tstoegi/MicroWakeupper/pics/6.2/P1.JPG

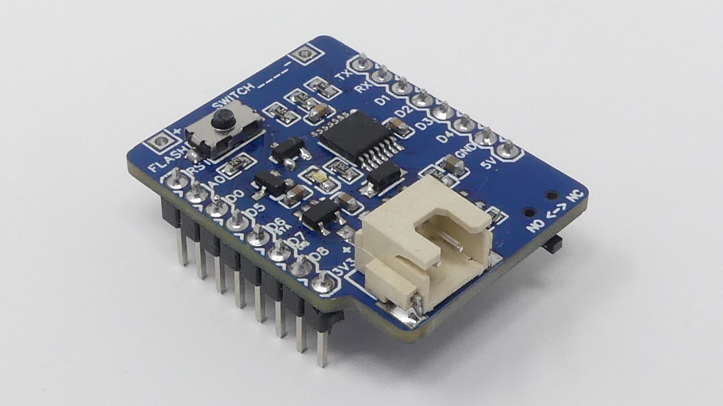
pics/6.2/P1.JPG
