tstoegi/MicroWakeupper/pics/6.2/P2.JPG

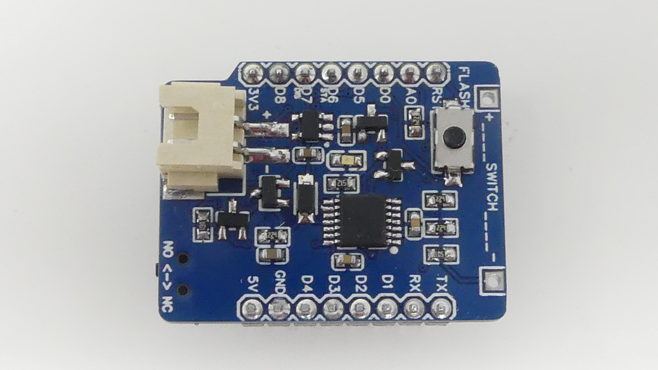
pics/6.2/P2.JPG
