tstoegi/MicroWakeupper/pics/6.2/P3.JPG

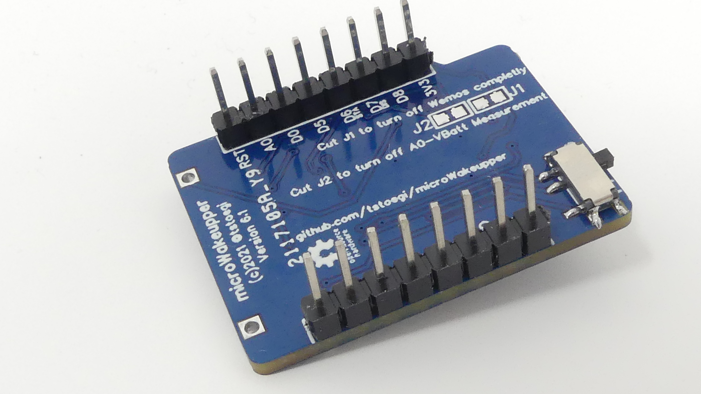
pics/6.2/P3.JPG
