tstoegi/MicroWakeupper/pics/6.2/P4.JPG

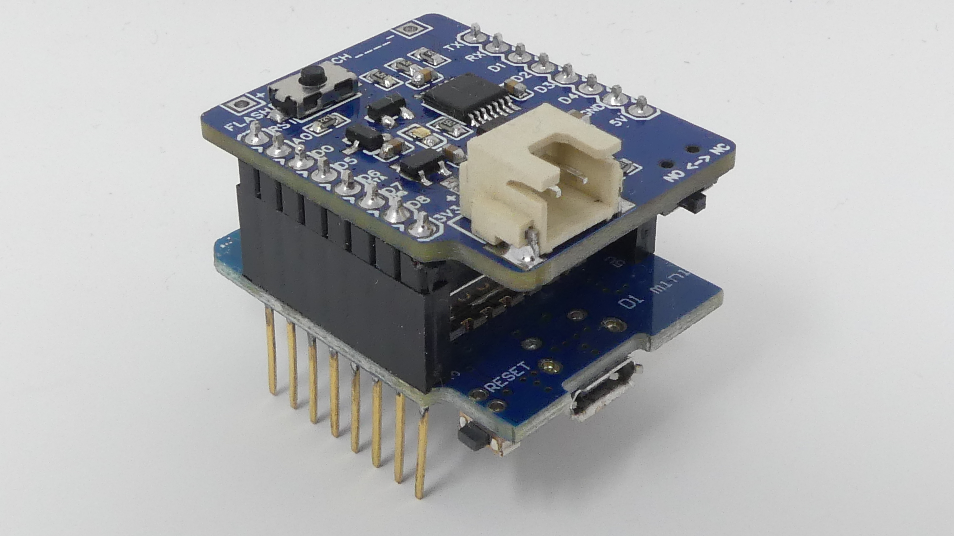
pics/6.2/P4.JPG
