tstoegi/MicroWakeupper/pics/6.3/P3.JPG

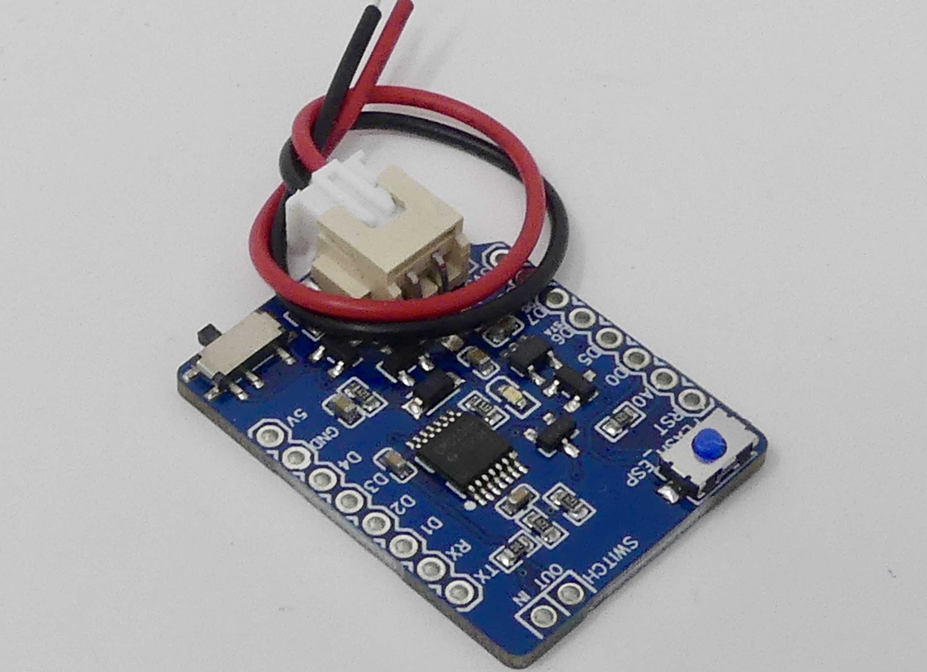
pics/6.3/P3.JPG
