tstoegi/MicroWakeupper/pcb/Gerber_R7_1/BOM_MicroWakeupper_R7_1_MicroWakeupper_WemosShield_R7_1_2025-09-15.xlsx

No. | Quantity | Comment | Designator | Footprint | Value | Manufacturer Part | Manufacturer | Supplier Part | Supplier
1 | 2 | 100nF | C1,C2 | C0603 |  | CC0603KRX7R9BB104 | YAGEO(国巨) | C14663 | LCSC
2 | 1 | 22uF | C4 | C0603 |  | CL10A226MQ8NRNC | SAMSUNG(三星) | C59461 | LCSC
3 | 2 | 1uF | C5,C6 | C0603 |  | CL10A105KB8NNNC | SAMSUNG(三星) | C15849 | LCSC
4 | 1 | WAFER-254W-2A | CN1 | CONN-SMD_2P-L10.0-W7.8-P2.5 |  | WAFER-254W-2A | HANBO(汉博) | C2874547 | LCSC
5 | 1 | B5819W_C8598 | D1 | SOD-123_L2.7-W1.6-LS3.7-RD-1 |  | B5819W SL | CJ(江苏长电/长晶) | C8598 | LCSC
6 | 2 | 0603 | J1,J2 | R0603 CUTTABLE JUMPER
7 | 1 | KT-0603R | LED1 | LED0603-RD |  | KT-0603R | KENTO | C2286 | LCSC
8 | 2 | 2N7002 | Q1,Q2 | SOT-23-3_L2.9-W1.3-P1.90-LS2.4-BR |  | 2N7002 | CJ(江苏长电/长晶) | C8545 | LCSC
9 | 1 | BC847B | Q3 | SOT-23-3_L2.9-W1.3-P1.90-LS2.4-BR |  | BC847B | UMW(友台半导体) | C545561 | LCSC
10 | 1 | SI2301CDS-T1-GE3 | Q4 | SOT-23-3_L3.0-W1.7-P0.95-LS2.9-BR |  | SI2301CDS-T1-GE3 | VISHAY(威世) | C10487 | LCSC
11 | 4 | 220K | R1,R2,R4,R8 | R0603 |  | 0603WAF2203T5E | UNI-ROYAL(厚声) | C22961 | LCSC
12 | 1 | 5.1K | R3 | R0603 |  | 0603WAF5101T5E | UNI-ROYAL(厚声) | C23186 | LCSC
13 | 1 | 1M | R5 | R0603 |  | 0603WAF1004T5E | UNI-ROYAL(厚声) | C22935 | LCSC
14 | 1 | 150 | R6 | R0603 |  | 0603WAF1500T5E | UNI-ROYAL(厚声) | C22808 | LCSC
15 | 1 | MSK12C02-HB | SW1 | SW-TH_MSK12C02-HB-1 |  | MSK12C02-HB | SHOU HAN(首韩) | C431541 | LCSC
16 | 1 | CD40106BPWR | U1 | TSSOP-14_L5.0-W4.4-P0.65-LS6.4-BL |  | CD40106BPWR | TI(德州仪器) | C58834 | LCSC
17 | 1 | AP2112K-3.3TRG1 | U2 | SOT-25-5_L3.0-W1.8-P0.95-LS3.0-BR |  | AP2112K-3.3TRG1 | DIODES(美台) | C51118 | LCSC
18 | 1 | KSR223GNCLFG | U3 | KEY-SMD_L6.0-W3.8-LS7.3 |  | KSR223GNCLFG | C&K | C221787 | LCSC
