tstoegi/MicroWakeupper/pcb/Gerber_R6_3/BOM_MicroWakeupper_WemosShield_R6_3_2022-01-18.csv

ID | Name | Designator | Footprint | Quantity | Manufacturer Part | Manufacturer | Supplier | Supplier Part | Price
1 | 0603 | J2,J1 | R0603 CUTTABLE JUMPER | 2
2 | 19-217/BHC-ZL1M2RY/3T | LED1 | LED0603-R-RD_BLUE | 1 | 19-217/BHC-ZL1M2RY/3T | EVERLIGHT | LCSC | C72041 | 0.018
3 | 2501SMT-2P | CN2 | CONN-SMD_2501SMT-2P | 1 | - | Shenzhen Cankemeng | LCSC | C132477 | 0.137
4 | ATS2D1GNCLFS | SW1-NC | KEY-SMD_L6.0-W3.7-LS7.3 | 1 | ATS2D1GNCLFS | C&K | LCSC | C221561 | 0.575
5 | CD40106BPWR | U1 | TSSOP-14_L5.0-W4.4-P0.65-LS6.4-BL | 1 | CD40106BPWR | TI | LCSC | C58834 | 0.331
6 | AP2112K-3.3TRG1 | U2 | SOT-25-5_L3.0-W1.8-P0.95-LS3.0-BR | 1 | AP2112K-3.3TRG1 | DIODES | LCSC | C51118 | 0.176
7 | MSK12C02-HB | SW1 | SW-TH_MSK12C02-HB | 1 | MSK12C02-HB | SHOU HAN | LCSC | C431541 | 0.059
8 | BC847B-C8575 | Q3 | SOT-23-3_L2.9-W1.3-P1.90-LS2.4-BR | 1 | BC847B | CJ | LCSC | C8575 | 0.022
9 | 150 | R6 | R0603 | 1 | 0603WAF1500T5E | UniOhm | LCSC | C22808 | 0.001
10 | 100nF | C1,C2 | C0603 | 2 | CC0603KRX7R9BB104 | YAGEO | LCSC | C14663 | 0.003
11 | 220K | R4,R8,R1,R2 | R0603 | 4 | 0603WAF2203T5E | UniOhm | LCSC | C22961 | 0.001
12 | SI2301CDS-T1-GE3 | Q4 | SOT-23-3_L3.0-W1.7-P0.95-LS2.9-BR | 1 | SI2301CDS-T1-GE3 | VISHAY | LCSC | C10487 | 0.082
13 | 1uF | C5,C6 | C0603 | 2 | CL10A105KB8NNNC | SAMSUNG | LCSC | C15849 | 0.005
14 | 5.1K | R3 | R0603 | 1 | 0603WAF5101T5E | UniOhm | LCSC | C23186 | 0.001
15 | 2N7002 | Q1,Q2 | SOT-23-3_L2.9-W1.3-P1.90-LS2.4-BR | 2 | 2N7002 | CJ | LCSC | C8545 | 0.026
16 | B5819W_C8598 | D1 | SOD-123_L2.8-W1.8-LS3.7-RD | 1 | B5819W | CJ | LCSC | C8598 | 0.053
17 | 1M | R5 | R0603 | 1 | 0603WAF1004T5E | UniOhm | LCSC | C22935 | 0.001
18 | 22uF | C4 | C0603 | 1 | CL10A226MQ8NRNC | SAMSUNG | LCSC | C59461 | 0.009
