tstoegi/MicroWakeupper/pcb/Schematic_MicroWakeupper_R7_1.pdf

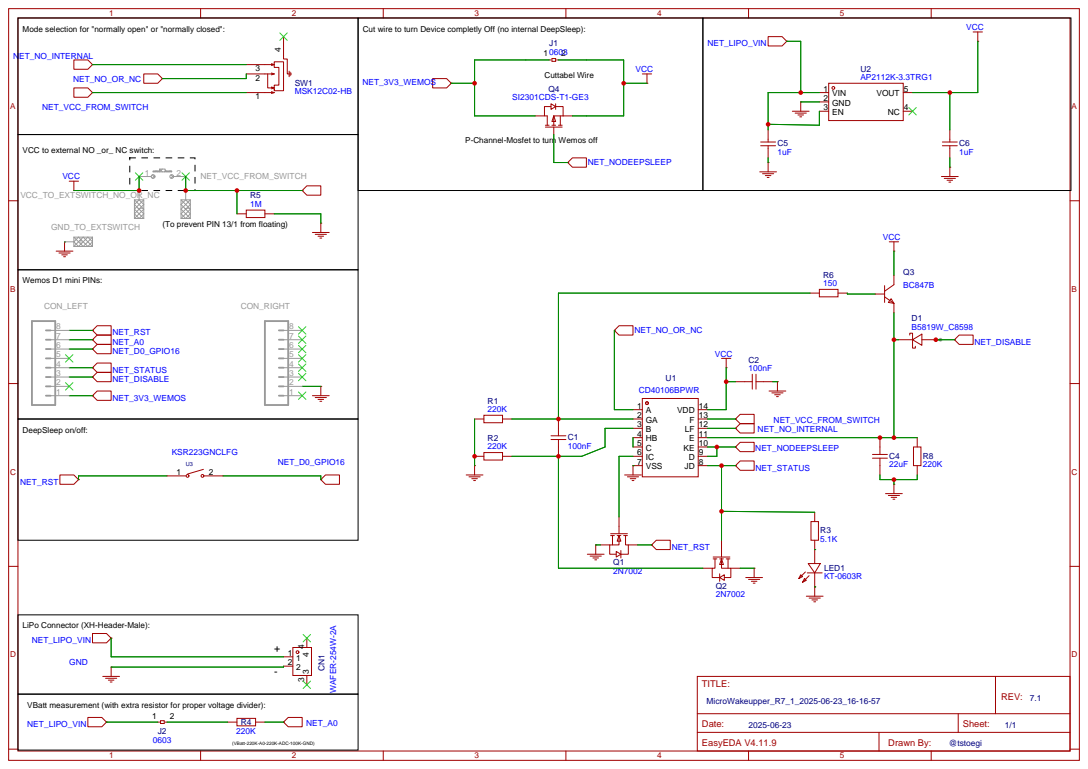
[picture p8: page 1]

Mode selection for "normally open" or "normally closed":

Cut wire to turn Device completly Off (no internal DeepSleep):

P-Channel-Mosfet to turn Wemos off

VCC to external NO _or_ NC switch:

(To prevent PIN 13/1 from floating)

LiPo Connector (XH-Header-Male):
NET_LIPO_VIN

VBatt measurement (with extra resistor for proper voltage divider):
