tstoegi/MicroWakeupper/(threads)

Thread 1 (2019-04-28):

absolute off-power instead of deepsleep

mzy2240, 2019-04-28:
Hi, this is an amazing and useful board for battery-powered esp project.  If I understand correctly, the microwakeupper board will wake up the deepsleeping esp. Is it possible to power up the esp when needed instead of keeping it in the deep sleep mode? Will that make the battery last longer? Thanks.

tstoegi, 2021-09-20:
Thanks for your feedback.
Just cut the jumper labeled as "J1" and the shield will take care about turning VIN on/off (in the case of the external event).

Closed 2021-12-10.

Thread 4 (2022-08-11):

Gerber

danielducu, 2022-08-11:
Any chances to get the Gerber file ? Thanks

tstoegi, 2022-08-12:
Added to the pcb folder. Enjoy!

danielducu, 2022-08-17:
> Added to the pcb folder. Enjoy!

Thanks a lot man! Would definitely buy some directly from you just to support your great work. Greetings from Spain.

tstoegi, 2022-12-23:
U are welcome.

Closed 2022-12-23.

Thread 7 (2024-01-07):

Question schematic

hazcoper, 2024-01-07:
Sorry, a bit of a noob question here, but looking at the schematic I am failing to see what the pins d6 and d7 are used for

tstoegi, 2024-01-07:
D6 (STA) - called "Status PIN" - reading HIGH means, the MicroWakeupper (your connected switch) was triggered (is active) - was closed or opened - depending on your setting (NC/NO)
D7 (DIS) - called "Disable PIN" - setting to HIGH means, preventing the MicroWakeupper going back into standby/sleep - as long as this PIN is set to HIGH, the connected switch is ignored. If you set D7 to LOW, after about 2 seconds the MicroWakeuper is ready for the next switch event.

(Just saw that I have to update schematic to revision 6.5 - there have been some minor changes.)

hazcoper, 2024-01-07:
without any extra code, what happens if the DIS pin is low, the esp is running and I press the button connected to the microwakeupper?

tstoegi, 2024-01-08:
By default the MicroWakeupper will reset (RST PIN goes LOW) your running esp and after about 2 seconds it goes back into "standby" - waiting for the next button press.
