tstoegi/MicroWakeupper/(commit log)

2018-12-13 Turn on internal LED during wait
2018-12-13 LED now works (LOW!)
2019-01-07 Create Schematic_microWakeupper_R3.pdf
    Update from Revision 2 to 3
2019-01-08 Updated current consumption.
2019-01-13 DIS Pin GPIO boot
2019-01-30 Updated current measurements
2021-05-21 Upload Schematic R6.2
2022-02-03 Update 6.2 to 6.3
    Updated from 6.2. to 6.3.
    Just minor changes on the board layout.
    1. Switch Connector
    2. Additional +/- below XH
    3. NO/NC Switch on the top side now
2022-02-03 Update 6.2 to 6.3
    No changes in the schematic.
2022-08-12 Added Gerber revision 6.3 files
    [BOM_MicroWakeupper_WemosShield_R6_3_2022-01-18.csv, PickAndPlace_MicroWakeupper_WemosShield_R6_3_2022-01-18.csv]
2026-01-30 Add CLAUDE.md with project documentation for Claude Code
    Provides guidance on project overview, build instructions, architecture,
    and API patterns for the MicroWakeupper Arduino library.
2026-01-30 Update to PCB revision 7.1
    - Add schematic PDF and Gerber/BOM files for R7.1
    - Add photos of assembled R7.1 board
    - Update library version to 7.1.0
    - Update README with new revision and photos
    [BOM_MicroWakeupper_R7_1_MicroWakeupper_WemosShield_R7_1_2025-09-15.xlsx, PickAndPlace_MicroWakeupper_WemosShield_R7_1_2025-09-15.xlsx]
2026-01-30 Redesign README with modern styling
    - Add badges (Arduino Library, GitHub Release, License, Open Source HW)
    - Add feature list, current consumption table, API reference
    - Include installation guide and quick start code example
    - Restructure with clean sections and tables
    - Fix image sizing for consistent display
2026-02-03 Fix resetedBySwitch() detection with RTC memory (v7.1.2) (#9)
    * Fix resetedBySwitch() detection using RTC memory (v7.1.1)
    Implements RTC-based state persistence to correctly distinguish between
    MicroWakeupper triggers and other wakeup sources (timer, reset, cold boot).
    Changes:
    - Add RTC memory structure to persist MicroWakeupper state across deep sleep
    - Update begin() to check RTC state and correctly determine switch trigger
    - Update reenable() to save state before deep sleep
    - Add interactive test sketch with flexible library selection (#ifdef)
    - Improve reenable() documentation in example
    The previous implementation couldn't reliably detect switch triggers vs.
    hardware resets. Now use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
    [InteractiveTest.ino, MicroWakeupper.cpp, MicroWakeupper.h, MicroWakeupperDemo.ino]
